SamC873/FUSF_Hydrophone_Scanner/FUSF Hydrophone Bill of Materials.xlsx

Product | Manufacturer | Quantity (# per pack) | Cost per pack | Total | URL | Dimensions | Technical Description
Breadboard | HiLetgo | 1 (3) | $5.99 | $5.99 | Amazon Breadboard (https://www.amazon.com/HiLetgo-Solderless-Breadboard-Circuit-Prototyping/dp/B00LSG5BJK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) | 84 x 54 x 9 mm | Solderless breadboard 400 Tie; Suitable for 21-26 AWG wires; self-adhesive tape on back
Electrical wire | TUOFENG | 1 (1) | $14.49 | $14.49 | Amazon Wire (https://www.amazon.com/TUOFENG-Wire-Solid-different-colored-spools/dp/B07TX6BX47) | 5.12 x 2.48 x 2.44 in | Weight: 13.4 oz; Diameter: 1.55 mm; 22 awg Solid Copper Wire Kit with PVC insulation; 6 colors
Heat Shrink | innhom | 1 (1) | $9.79 | $9.79 | Amazon Heat Shrink (https://www.amazon.com/innhom-615pcs-Shrink-Tubing-Approved/dp/B07GS7PBHV) | Diameters: 1/24" to 4/7" | Irradiation cross-linked polyolefin material; 2:1 shrink ratio; 650 pcs
Nema 17 Stepper motor | Adafruit | 4 (1) | $14 | $56.00 | Adafruit Motor (https://www.adafruit.com/product/324) | 42 mm body; 31 mm holes | Nema 17 Datasheet (https://cdn-shop.adafruit.com/product-files/324/C140-A+datasheet.jpg)
Synthetos gShield Motor Driver | Adafruit | 1 (1) | $63 | $63.00 | Adafruit Driver (https://www.adafruit.com/product/1750) | 58 x 78 x 2 mm | Github g-shield Datasheet (https://github.com/synthetos/grblShield/tree/master/hardware/gshield_v5_schematic)
Limit Switch | Cylewet | 1 (6) | $6.99 | $6.99 | Amazon Limit Switch (https://www.amazon.com/gp/product/B071NSRHK3/ref=ppx_yo_dt_b_search_asin_title?ie=UTF8&psc=1) | 2.8 x 1.6 x 1 cm | 1-way circuit; SPDT Micro Limit Switch with Hinge Lever Arm
Arduino Uno R3 | Arduino | 1 (1) | $19.98 | $19.98 | Amazon Arduino (https://www.amazon.com/Arduino-A000066-ARDUINO-UNO-R3/dp/B008GRTSV6?s=industrial) | 3.15 x 2.17 x 0.98 in | 8 KB RAM; Rev 3; Model # A000066
Power Supply | ALITOVE | 1 (1) | $20.99 | $20.99 | Amazon Power Supply (https://www.amazon.com/ALITOVE-100-240V-Converter-Transformer-5-5x2-1mm/dp/B07MXXXBV8) | 5.5 x 2.5 x 2.1 mm DC Jack | 8A, 12V DC, 96 W Output; 100~240V AC Input; DC Jack Output Port
Power Pigtail Cables | LUOYIMAO | 1 (10) | $9.99 | $9.99 | Amazon Pigtail Cable (https://www.amazon.com/Pigtail-12V-24V-Connectors-Security-Lighting/dp/B07P7CP6HC?s=electronics) | 5.5 x 2.1 mm barrel | 12-24V, 10 A DC Male and Female Connectors
20-2020 T-Slot Profile | 80/20 | 8 (1) | 6.99*2 + 3.84*4 + 4.47*2 | $38.28 | 8020.net Profile (https://8020.net/20-2020.html) | 20 x 20 x 400 mm total | 20-2020 is a 20mm x 20mm metric 20 series square T-slot profile with four open T-slots, one on each 20mm face
MGN9H Rail Carriages | Hanpose | 6 (1) | $4.64 | $27.84 | Aliexpress Carriages (https://www.aliexpress.com/item/33036084391.html?spm=a2g0o.cart.0.0.28b73c00fcy7U7) | 9 mm guide width | MGN9H linear rail slider fit glider
Linear Rails | Hanpose | 6 (1) | 7.43*2 + 27.89*2 + 11.15*2 | $92.94 | Aliexpress Rails (https://www.aliexpress.com/item/33036084391.html?spm=a2g0o.cart.0.0.28b73c00fcy7U7) | 2x250, 2x700, 2x350 mm | MGN9H linear rail slider; total 2600 mm length; fit for 9 mm guide width glider
2020 Extrusion M3 T-nut | Boeray | 1 (50) | $7.99 | $7.99 | Amazon T-nut (https://www.amazon.com/gp/product/B01GCDG2QE/ref=ox_sc_act_title_3?smid=A3J5E5ZOT6VBB2&psc=1) | 10 x 10 x 5 mm | M3 slide in T-nut meant for 2020 Series Extrusion; 6 mm slot width; carbon steel material with nickel surface finish
2020 Extrusion M3 T-nut alt | Asayu | 1 (100) | $8.99 | $8.99 | Amazon T-nut (https://www.amazon.com/100-Pack-T-Nuts-Aluminum-Profile-Accessories/dp/B07KSCKJP1?s=hi) | 3 x 2 x 0.2 in | 2020 Series M3 T-Nuts, Carbon Steel T-Slot Nut 6 mm Slot Aluminum Profile
M3 Hex Socket Screws | Iexcell | 2 (125) | $8.99 | $17.98 | Amazon Screws (https://www.amazon.com/gp/product/B07GVV9Q82/ref=ox_sc_act_title_2?smid=A1ZRRCZIF57JQ9&psc=1) | M3x8/10/12/16/20 mm | 250 total pcs, Hex Socket Button head cap screws; M3 x 8/10/12/16/20 mm; Material: Stainless Steel 304; Includes 1 Hex Key size 2.0 mm
T8 Anti Backlash Brass Nut | HJ Garden | 1 (4) | $11.99 | $11.99 | Amazon Backlash Nut (https://www.amazon.com/dp/B07QFTQ5PN?%22VkaXJlY3QmZG9Ob3RMb2dDbGljaz10cnVl) | D 8, Pitch 2, Lead 2 mm | Brass T type thread; T8 Anti Backlash Spring Loaded Nut with 2mm Lead suitable for 2 mm lead Threaded Rod; Pack of 4 (4x Large Nut, 4x Small Nut, 4x Spring)
Flexible Couplings | OctagonStar | 2 (2) | $6.26 | $12.52 | Amazon coupler (https://www.amazon.com/gp/product/B01HBPHSII/ref=ox_sc_mini_detail?ie=UTF8&psc=1&smid=A3UZFN1XV8TPA1) | 0.98 x 0.79 x 1.57 in | Flexible couplings compatible with NEMA 17 stepper motors for 5 mm to 8 mm shaft diameter
Rotational Flange Bearing | Eowpower | 1 (4) | $8.99 | $8.99 | Amazon Flanged Bearing (https://www.amazon.com/Eowpower-Diameter-Flanged-Mounted-Bearing/dp/B07K6B8M4P) | 48 x 27 x 12 mm; 8 mm bore D | 4 Pcs 8 mm Bore Diameter Flanged Ball Mounted Pillow Block Insert Bearing; Material: Zinc Alloy; Mounting Hole Diameter: 5mm; Mounting Hole Distance 37 mm; Attachment mounts parallel to axis through bore hole
Rotational Bearing | Eowpower | 2 (4) | $8.99 | $17.98 | Amazon bearing (https://www.amazon.com/gp/product/B01MT1MODX/ref=ox_sc_act_title_1?smid=A1M8G92U41XEUX&psc=1) | 55 x 28 x 13 mm; 8 mm bore D | 4 Pcs 8 mm Bore Diameter Ball Mounted Pillow Block Insert Bearing; Material: Zinc Alloy; Mounting Hole Diameter: 5mm; Mounting Hole Distance 44 mm; Attachment mounts perpendicular to axis through bore hole
T8 Lead Screw/Nut | Kaifa | 4 (1) | $8.99 *2 + $16.99 * 2 | $51.96 | Amazon Lead Screw (https://www.amazon.com/Length-100mm-800mm-Copper-THSL-800-8D-Printer/dp/B019ML8ZOA) | 8MM D 800 and 400 mm L | T8 Lead screw Diameter of 8MM, Pitch 2 mm, Lead 2 mm, Length 2x400 mm and 2x800 mm with Copper Nut
Fish tank | Aqueon | 1 (1) | $69.99 | $69.99 | Petco (Find in Store) (https://www.petco.com/shop/en/petcostore/product/fish/fish-aquariums-kits/freestanding-large-fish-tanks/aqueon-standard-glass-aquarium-tank-29-gallon) | 30.625 x 13.25 x 19 in | 29 Gallons; Material: Glass
Cable Guide | URBEST | 1 (1) | $13.99 | $13.99 | Amazon Cable Guide (https://www.amazon.com/URBEST-Plastic-Flexible-Electrical-Machines/dp/B07DQMC6RD?s=hi) | 18 x 25 x 1000 mm | Plastic Flexible Nested Semi Closed Drag Chain Cable
 |  |  |  |  |  | *D refers to Diameter, L to Length
 |  |  | total | $588.66
