SamC873/FUSF_Hydrophone_Scanner/3D parts/x_axis_left_motor_mount.stl

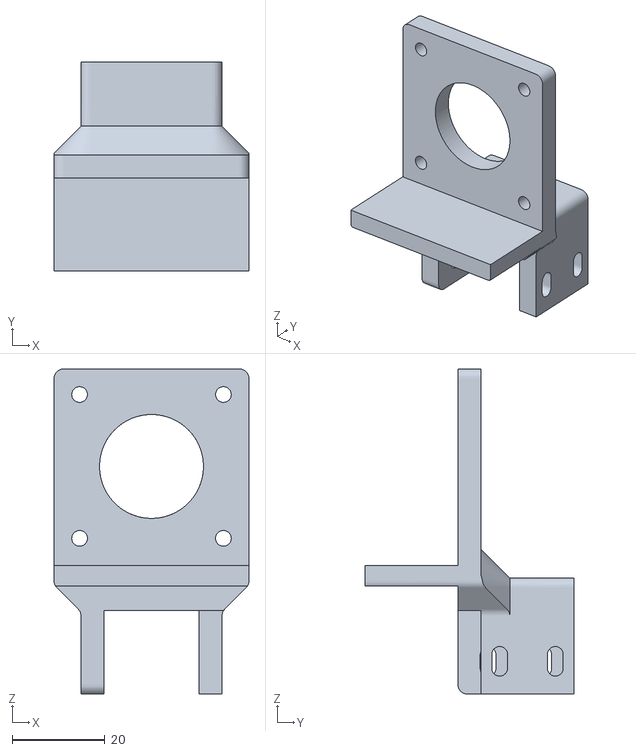
[picture p1: CAD file, 2021-04-07]
3D parts/x_axis_left_motor_mount.stl
42.0 x 45.0 x 70.0
