SamC873/FUSF_Hydrophone_Scanner/3D parts/z_back_support.stl

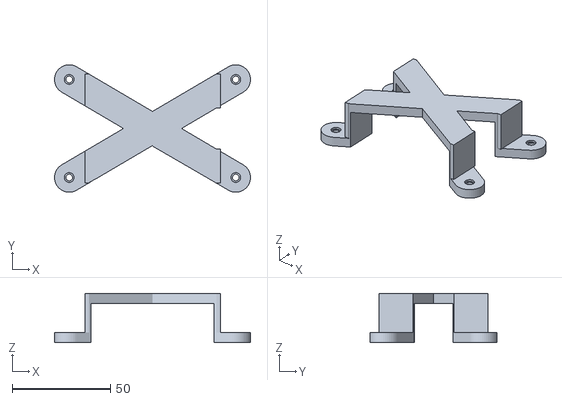
[picture p2: CAD file, 2021-04-07]
3D parts/z_back_support.stl
100.0 x 65.0 x 25.0
