SamC873/FUSF_Hydrophone_Scanner/3D parts/x_axis plate_right.stl

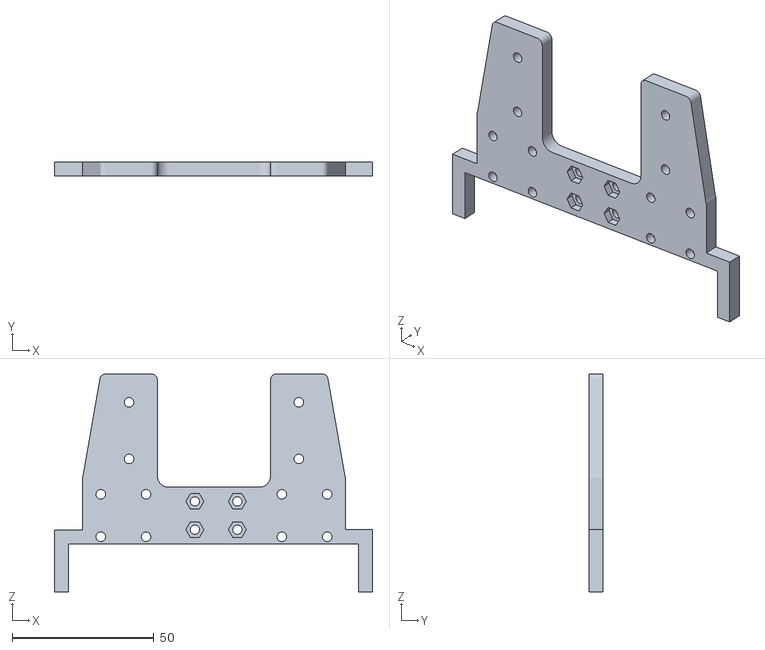
[picture p3: CAD file, 2021-04-07]
3D parts/x_axis plate_right.stl
112.4 x 5.00 x 77.0
