SamC873/FUSF_Hydrophone_Scanner/3D parts/Corner_Bracket.stl

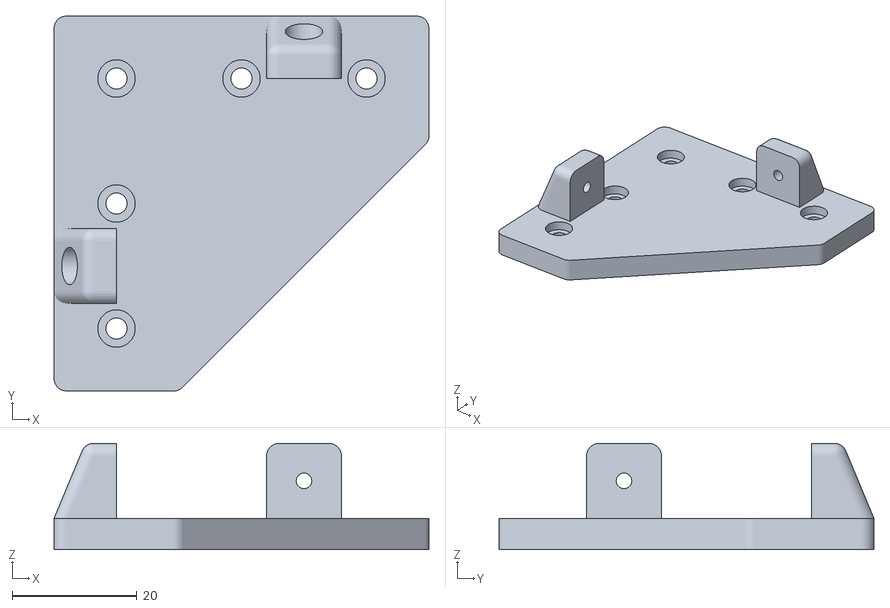
[picture p4: CAD file, 2021-04-07]
3D parts/Corner_Bracket.stl
60.0 x 60.0 x 17.0
