SamC873/FUSF_Hydrophone_Scanner/3D parts/Wire Holder.stl

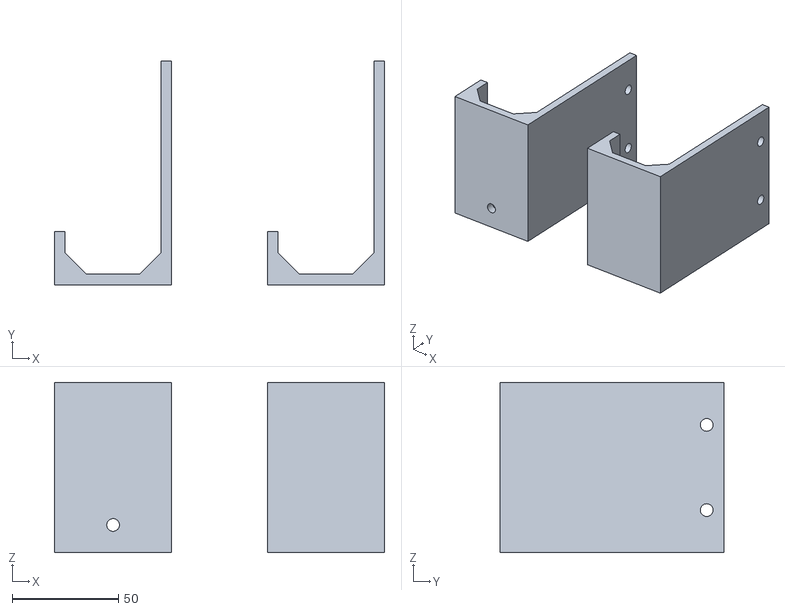
[picture p5: CAD file, 2021-04-07]
3D parts/Wire Holder.stl
155.0 x 105.0 x 80.0
