SamC873/FUSF_Hydrophone_Scanner/3D parts/x_axis plate_left.stl

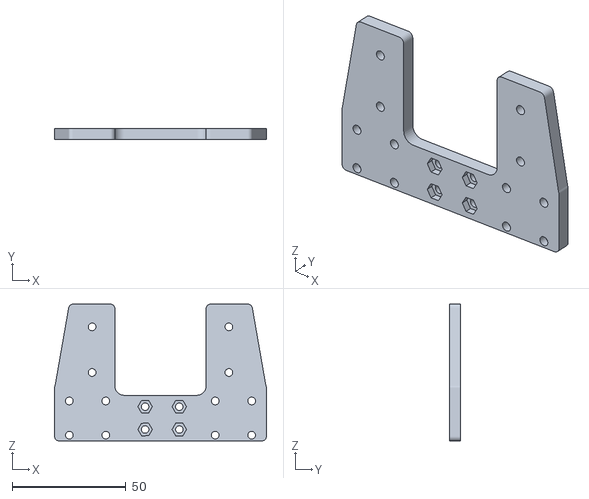
[picture p6: CAD file, 2021-04-07]
3D parts/x_axis plate_left.stl
93.0 x 5.00 x 60.0
