SamC873/FUSF_Hydrophone_Scanner/3D parts/Z_cap.stl

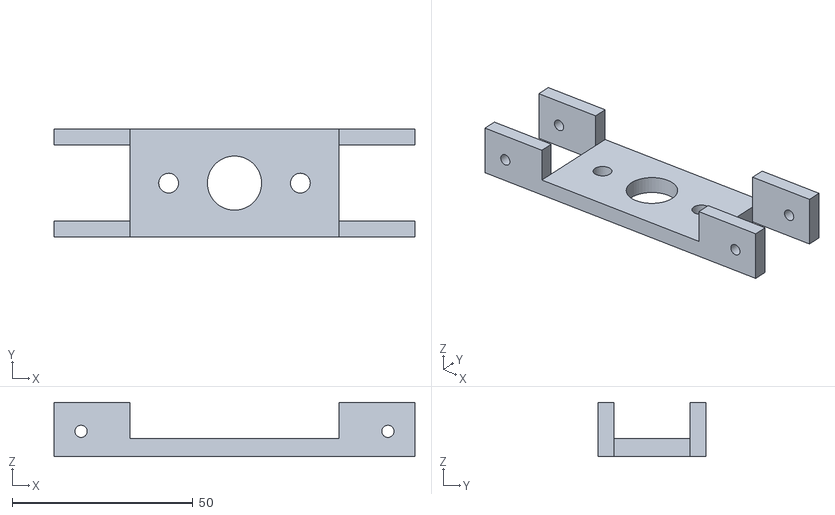
[picture p7: CAD file, 2021-04-07]
3D parts/Z_cap.stl
100.0 x 29.9 x 15.0
