SamC873/FUSF_Hydrophone_Scanner/3D parts/Y_axis_motor_mount.stl

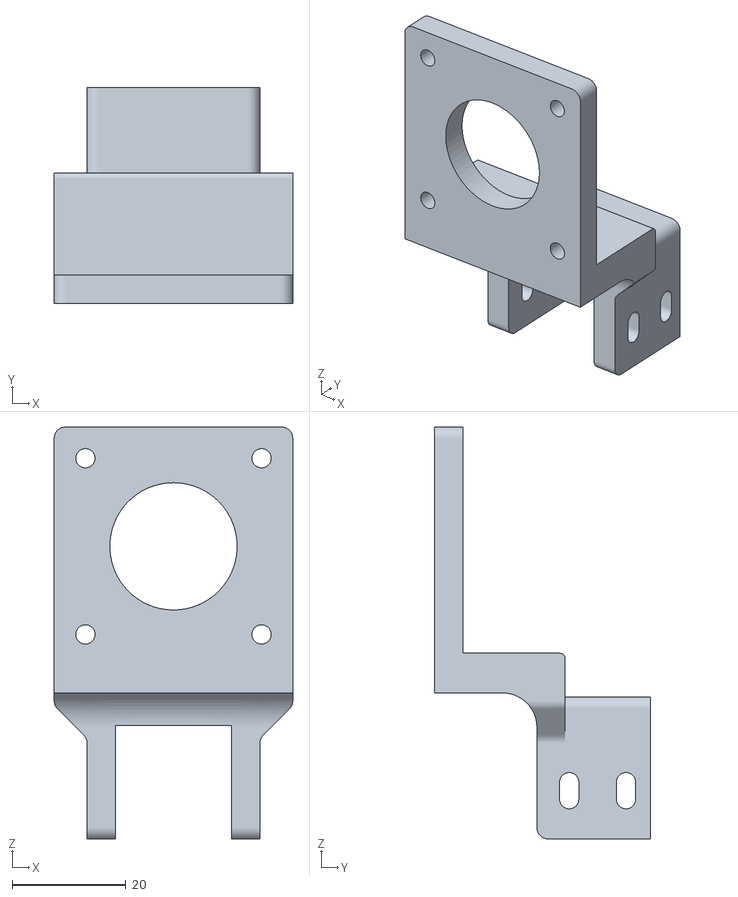
[picture p8: CAD file, 2021-04-07]
3D parts/Y_axis_motor_mount.stl
42.0 x 38.0 x 72.5
