SamC873/FUSF_Hydrophone_Scanner/3D parts/limit_mount.stl

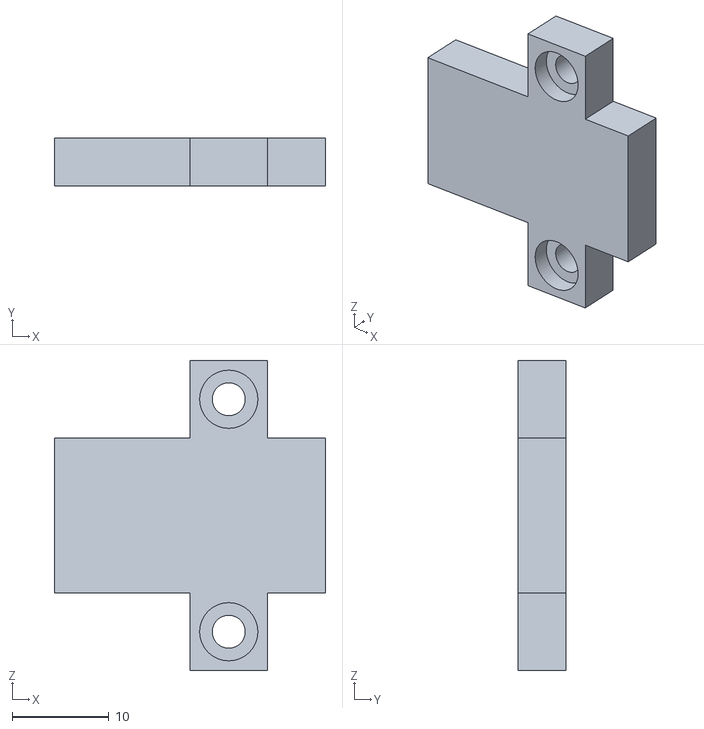
[picture p9: CAD file, 2021-04-07]
3D parts/limit_mount.stl
28.0 x 5.00 x 32.0
