SamC873/FUSF_Hydrophone_Scanner/3D parts/z_rod holder.stl

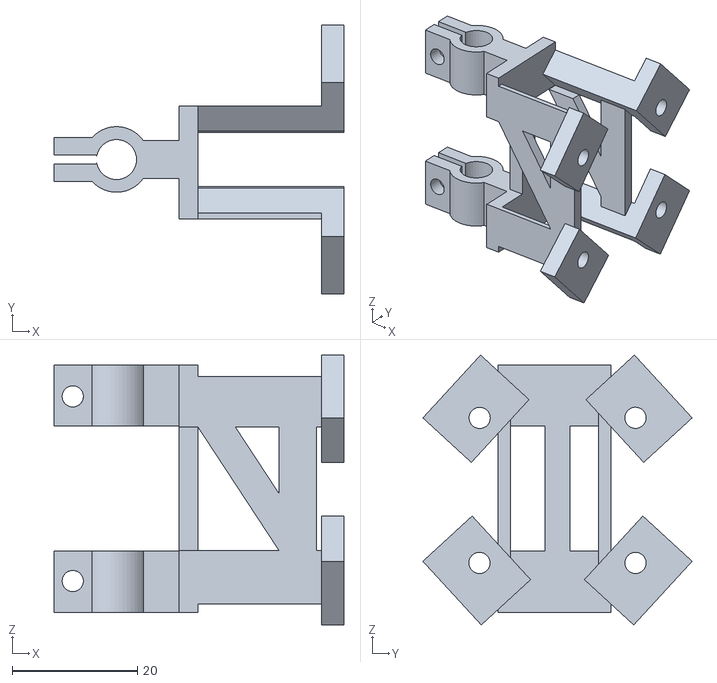
[picture p10: CAD file, 2021-04-07]
3D parts/z_rod holder.stl
46.4 x 43.1 x 43.2
