SamC873/FUSF_Hydrophone_Scanner/3D parts/z_motor_mount.stl

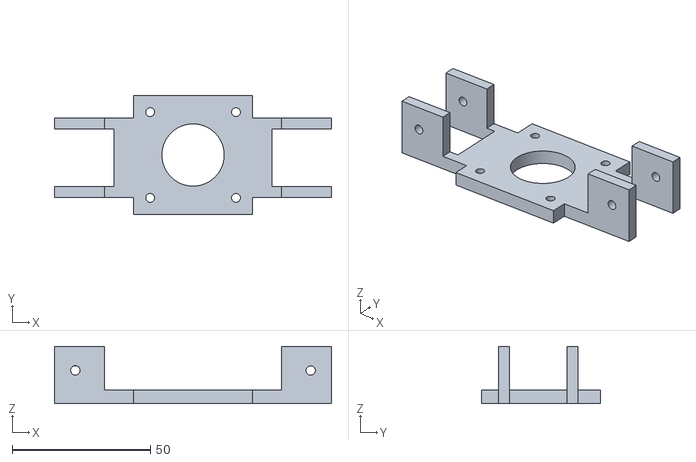
[picture p11: CAD file, 2021-04-07]
3D parts/z_motor_mount.stl
100.1 x 43.0 x 20.7
