SamC873/FUSF_Hydrophone_Scanner/3D parts/gShield_Controller_Box.stl

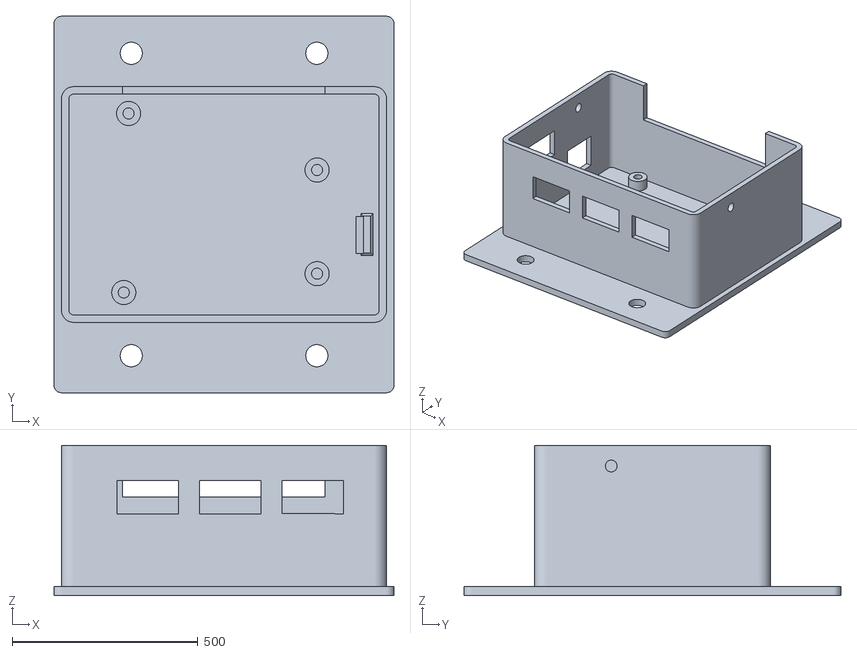
[picture p12: CAD file, 2021-04-07]
3D parts/gShield_Controller_Box.stl
916.3 x 1015.0 x 405.0
