SamC873/FUSF_Hydrophone_Scanner/3D parts/bearing_mount.stl

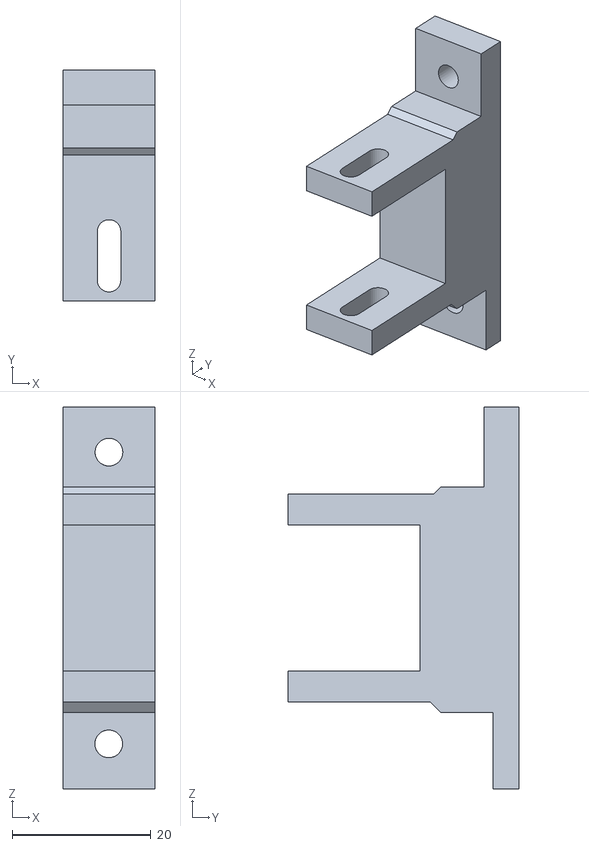
[picture p13: CAD file, 2021-04-07]
3D parts/bearing_mount.stl
13.2 x 33.2 x 55.0
