SamC873/FUSF_Hydrophone_Scanner/3D parts/y_carriage.stl

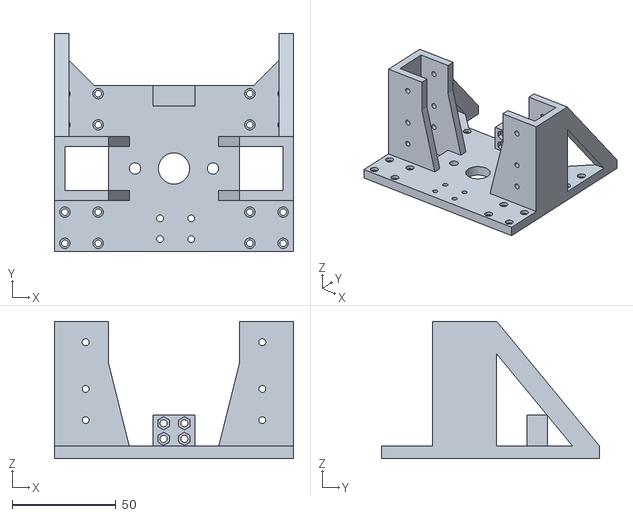
[picture p14: CAD file, 2021-04-07]
3D parts/y_carriage.stl
115.0 x 105.0 x 66.0
