SamC873/FUSF_Hydrophone_Scanner/3D parts/Rod Directional.stl

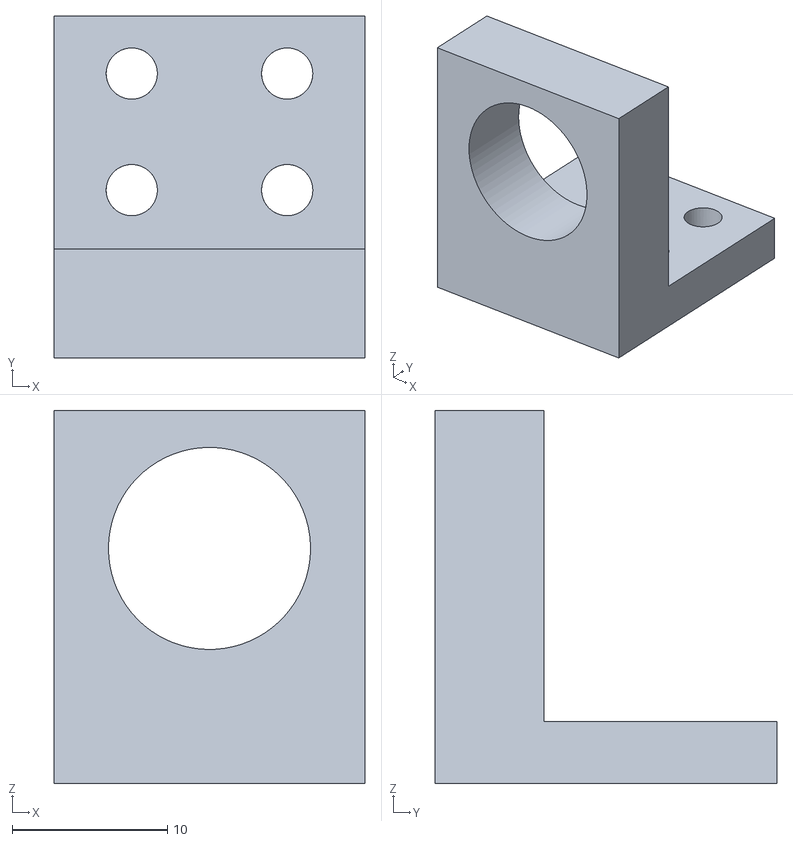
[picture p15: CAD file, 2021-04-07]
3D parts/Rod Directional.stl
20.0 x 22.0 x 24.0
