SamC873/FUSF_Hydrophone_Scanner/3D parts/Nut_Couple.stl

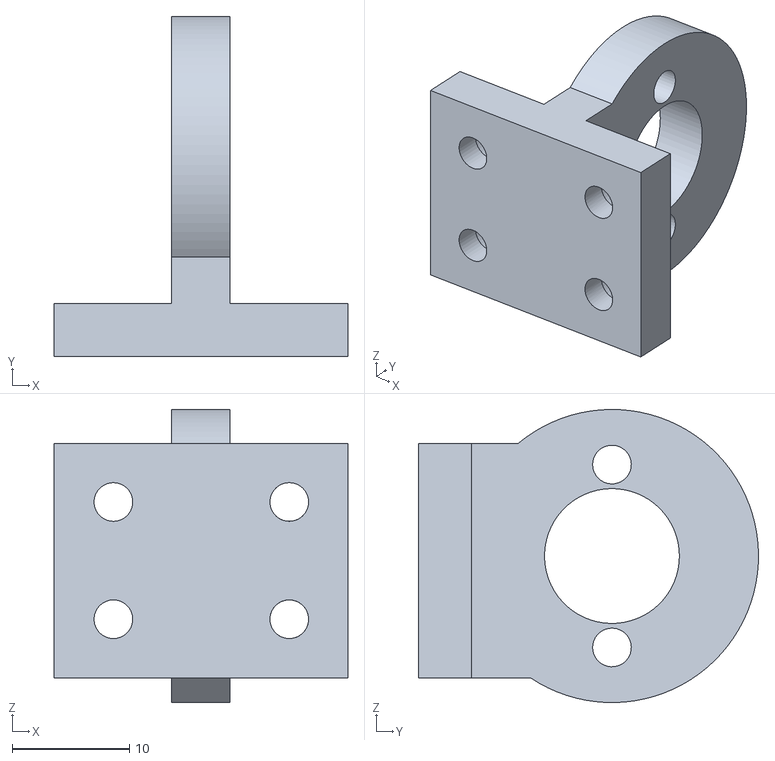
[picture p16: CAD file, 2021-04-07]
3D parts/Nut_Couple.stl
25.1 x 29.0 x 25.0
