SamC873/FUSF_Hydrophone_Scanner/3D parts/z_nut_carriage.stl

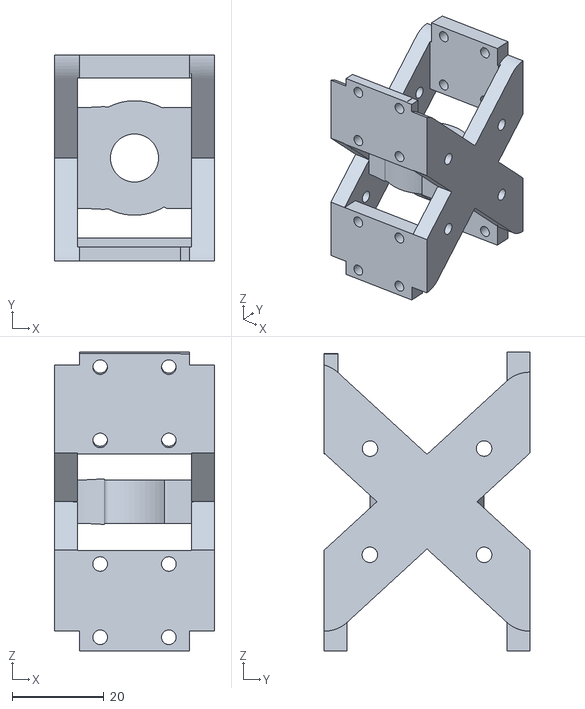
[picture p17: CAD file, 2021-04-07]
3D parts/z_nut_carriage.stl
35.0 x 45.0 x 65.3
