SamC873/FUSF_Hydrophone_Scanner/(list of files, cad)

Other CAD files:
3D parts/x_axis_right_motor_mount.stl
3D parts/Corner_Bracket.f3d
3D parts/Nut_Couple.f3d
3D parts/Rod Directional.f3d
3D parts/Y_axis_motor_mount.f3d
3D parts/Z_cap.f3d
3D parts/bearing_mount.f3d
3D parts/limit_mount.f3d
3D parts/x_axis plate_left.f3d
3D parts/x_axis plate_right.f3d
3D parts/x_axis_left_motor_mount.f3d
3D parts/x_axis_right_motor_mount.f3d
3D parts/y_carriage.f3d
3D parts/z_back_support.f3d
3D parts/z_motor_mount.f3d
3D parts/z_nut_carriage.f3d
3D parts/z_rod holder.f3d
