SamC873/FUSF_Hydrophone_Scanner/(threads)

Thread 1 (2022-02-07):

is:open label:question

Raptor-Queen, 2022-02-07:
Hello, I am trying to assemble this hydrophone tank, and have come across an issue when assembling the z-axis. Currently I am only trying to make the z-axis function.  When the arduino is powered and everything is connected, the motor will only run when the z limit switch is activated. The arduino interface also does not seem to do anything to the system. I am wondering if there is an error in wiring on my part. Everything seems to match the photos, but I noticed in the BOM there are breadboards. I have not used these, and am wondering if they are required for any part of the set up.
