SamC873/FUSF_Hydrophone_Scanner/(commit log)

2021-04-07 Create FUS_Hydrophone_Main
    MATLAB GUI to control stepper motors, function generator, and oscilloscope while conducing a hydrophone scan.
2021-07-30 Update FUSF Hydrophone Bill of Materials.xlsx
    Added descriptions of each piece in case product link is broken or unavailable.
    [FUSF Hydrophone Bill of Materials.xlsx]
2021-08-26 Update Bill of Materials
    Added product descriptions
    [FUSF Hydrophone Bill of Materials.xlsx]
2021-08-26 Update Arduino Program
    1. Updated limits for X,Y,Z motor movements from one limit switch extrema to other (X,Y,Z)  (511,68,170)
    a. Purpose: Response to reviewer comments and better idea of scan dimension capabilities
    b. Notes: Z axis limit measured to extent of Z-base 3D printed parts
    2. Changed the argument in pinMode to ‘INPUT_PULLUP’
    a. Purpose: Limit switches not registering before. Important due to constant noise in circuitry to have built-in resistor, activated by input_pullup, to effectively receive signal.
    b. Notes: Reads limit switch where a normally open circuit outputs ‘HIGH’ and an activated/closed switch connects to ground leading to 0 V or ‘LOW’ reading.
    3. Updat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
    [FUSF_Hydro_Arduino.ino]
2021-08-26 Update FUS_Hydrophone_Main.mlapp
    1. Introduced ‘getwave()’ function which extracts the wave data from the scope and converts to a 2xN matrix with time data and signal data
    a. Purpose: Used in the SNR calculator callback to find the signal to noise ratio. Can be used in other experiments including speed of sound measurements to acquire wave data at correct scales.
    b. Notes: Converts data from scope to us and mV. Most easily called through SNR Calculator.
    2. Introduced ‘New Origin’ button which sets current position to (0,0,0)
    a. Purpose: Allow user to customize coordinate plane for treatments or hydrophone positioning. Also allows movement of system without need to hard home.
    b. Notes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
2021-08-26 Update FUSF Hydrophone User Manual.pdf
    Described updates to Arduino script and Matlab GUI
